NaitMalekYoussef/Gloveraille/Code/Arduino/README.md

# Glovraille Arduino code
This is the Arduino code for the Glovraille project. this is just a test code, the final version is loading :smile:.
