NaitMalekYoussef/Gloveraille/Code/ESP32/gloveraille/config.ino

/*
                  LEFT HAND                                          RIGHT HAND
   
    \'''''\   |''''| |'''''| |''''| |''''|               |''''| |''''| |''''| |''''|   /'''''/
     \ GND \  | P6 | | P9  | | P3 | | P0 |               | P0 | | P3 | | P6 | | P9 |  / GND /
      \     \ | P7 | | P10 | | P4 | | P1 |               | P1 | | P4 | | P7 | |P10 | /     /
       \     \| P8 | | P11 | | P5 | | P2 |               | P2 | | P5 | | P8 | |P11 |/     /


                                           THE ALPHABET
                                           P6     P9
                                           P7     P10     
                                           P8     P11

*/
#define P0 0
#define P1 0
#define P2 0
#define P3 27
#define P4 26
#define P5 25
#define P6 15
#define P7 14
#define P8 13
#define P9 12
#define P10 4
#define P11 18
