NaitMalekYoussef/Gloveraille/(commit log)

2022-07-31 README updated, new images and Arduino code are added
2022-07-31 modified: README.MD modified: Schema.png modified: arduino_code/glovraille/functions.ino modified: arduino_code/glovraille/glovraille.ino new file: images/built_in_LED.JPG new file: images/built_in_L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
2022-07-31 modified: README.MD new file: arduino_code/README.md
